IEEE-UCF/boost_converter/lm5032 similar boost conv.asc

C1: cap; 100µ
C2: cap; 5µ
C3: cap; 4.7µ
C4: cap; 500µ
C5: cap; 1µ
C6: cap; 22n
C7: cap; 100p
C8: cap; 100n
D1: diode; VS-E5PH7506
D2: diode; VS-E5PH7506
L1: ind; 470n; Ipk=300 Rser=0.00025
L2: ind; 470n; Ipk=300 Rser=0.00025
M1: nmos; IPP030N10N3
M2: nmos; IPP030N10N3
M3: nmos; IPP030N10N3
M4: nmos; IPP030N10N3
M5: nmos; IPP030N10N3
M6: nmos; IPP030N10N3
M7: nmos; IPP030N10N3
M8: nmos; IPP030N10N3
M9: nmos; IPP030N10N3
M10: nmos; IPP030N10N3
M11: nmos; IPP030N10N3
M12: nmos; IPP030N10N3
M13: nmos; IPP030N10N3
M14: nmos; IPP030N10N3
M15: nmos; IPP030N10N3
M16: nmos; IPP030N10N3
R1: res; 2
R2: res; 2
R3: res; 0.00025
R4: res; 0.00025
R5: res; 25
R6: res; 69k
R7: res; 10k
R8: res; 63.4k
R9: res; 16k
R10: res; 100k
R11: res; 0
R12: res; 10k
U1: LT8277
V1: voltage; 30V
Named nets: 0, Vout, Vin
.tran 0 1s 0
