IEEE-UCF/boost_converter/LM5032 2 Board Design/New folder/LM5032 SB.kicad_pcb

## KiCad design LM5032 2 Board Design/New folder/LM5032 SB.kicad_pcb (2024-06-16)

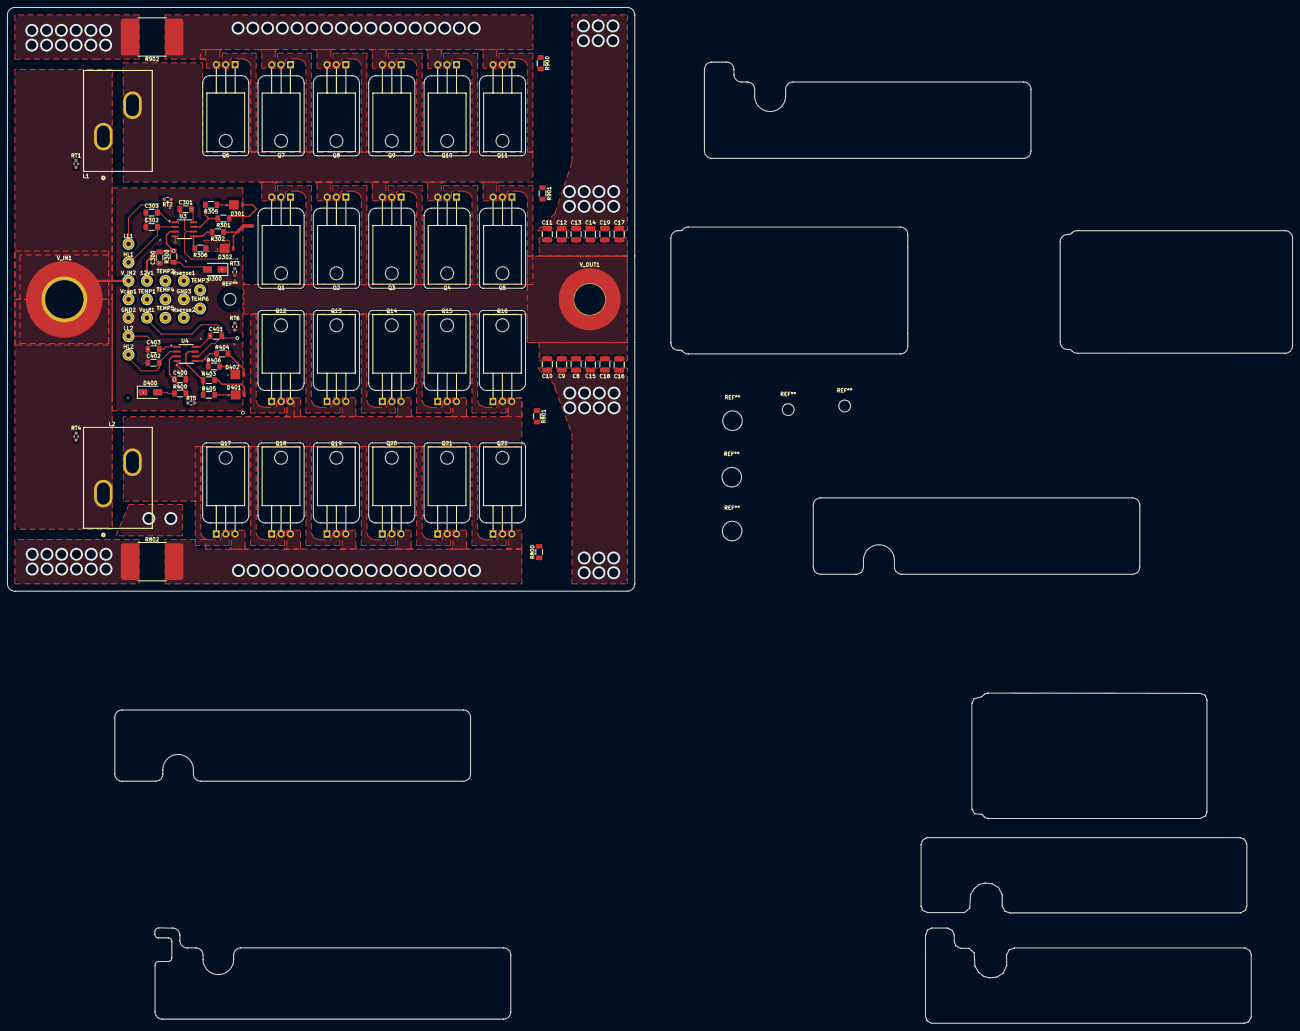
[picture p8: board LM5032 SB.kicad_pcb from above]

Board: 4 copper layers, 170.0 x 158.2 mm, 94 parts (0 on the bottom side), 34 nets.

Parts:
12V1: MountingHole_Pad; TestPoint_THTPad_D2.5mm_Drill1.2mm
C8, C9, C10, C11, C12, C13, C14, C15: 10uF; C_1210_3225Metric_Pad1.33x2.70mm_HandSolder
C16, C17, C18, C19: 0.1uF; C_1210_3225Metric_Pad1.33x2.70mm_HandSolder
C300, C400: 22uF; C_1206_3216Metric_Pad1.33x1.80mm_HandSolder
C301, C401: 2.2uF; C_1206_3216Metric_Pad1.33x1.80mm_HandSolder
C302, C303, C402, C403: 33pF; C_1206_3216Metric_Pad1.33x1.80mm_HandSolder
D300, D400: BYG20J-E3/TR; D_SMA
D301, D302, D401, D402: MBRM130LT1G
GND2, GND3: MountingHole_Pad; TestPoint_THTPad_D2.5mm_Drill1.2mm
HL1, HL2: MountingHole_Pad; TestPoint_THTPad_D2.5mm_Drill1.2mm
L1, L2: 470nH; EDITED-IND_IHDM1107BBEVR47M20_VIS
LL1, LL2: MountingHole_Pad; TestPoint_THTPad_D2.5mm_Drill1.2mm
Q1, Q2, Q3, Q4, Q5, Q6, Q7, Q8, Q9, Q10, Q11, Q12, Q13, Q14, Q15, Q16, Q17, Q18, Q19, Q20, Q21, Q22: NMOS; TO-220-3_Horizontal_TabDown edited pins
R300, R400: 49.9; R_1206_3216Metric_Pad1.30x1.75mm_HandSolder
R301, R302, R403, R404: 3.3; R_1206_3216Metric_Pad1.30x1.75mm_HandSolder
R305, R306, R405, R406: 2.2; R_1206_3216Metric_Pad1.30x1.75mm_HandSolder
R800, R801, R900, R901: 1k; R_1206_3216Metric_Pad1.30x1.75mm_HandSolder
R802, R902: 0.0001; PSR500HTQFB0L10
RT1, RT2, RT3, RT4, RT5, RT6: 36.5k; R_0603_1608Metric_Pad0.98x0.95mm_HandSolder
Rsense1, Rsense2: MountingHole_Pad; TestPoint_THTPad_D2.5mm_Drill1.2mm
TEMP1, TEMP2, TEMP3, TEMP4, TEMP5, TEMP6: MountingHole_Pad; TestPoint_THTPad_D2.5mm_Drill1.2mm
U3, U4: UCC27712DR; SOIC127P599X175-8N
V_IN1: MountingHole_Pad; MountingHole_8.4mm_M8_Pad_TopBottom
V_IN2: MountingHole_Pad; TestPoint_THTPad_D2.5mm_Drill1.2mm
V_OUT1: MountingHole_Pad; MountingHole_8.4mm_M8_Pad_TopBottom
Vcap1: MountingHole_Pad; TestPoint_THTPad_D2.5mm_Drill1.2mm
Vout1: MountingHole_Pad; TestPoint_THTPad_D2.5mm_Drill1.2mm

Connections:
/12V: 12V1.1, C300.2, C400.2, R300.2, R400.2, U3.3 (VDD), U4.3 (VDD)
/HL1: C302.2, HL1.1, U3.2 (HL)
/HL2: C402.2, HL2.1, U4.2 (HL)
/HO1: D301.2 (A), Q1.2 (G), Q2.2 (G), Q3.2 (G), Q4.2 (G), Q5.2 (G), R301.1, R901.2
/HO2: D401.2 (A), Q12.2 (G), Q13.2 (G), Q14.2 (G), Q15.2 (G), Q16.2 (G), R403.1, R801.2
/LL1: C303.2, LL1.1, U3.1 (LL)
/LL2: C403.2, LL2.1, U4.1 (LL)
/LO1: D302.2 (A), Q6.2 (G), Q7.2 (G), Q8.2 (G), Q9.2 (G), Q10.2 (G), Q11.2 (G), R302.1, R900.2
/LO2: D402.2 (A), Q17.2 (G), Q18.2 (G), Q19.2 (G), Q20.2 (G), Q21.2 (G), Q22.2 (G), R404.1, R800.2
/Rsense1: Q6.3 (S), Q7.3 (S), Q8.3 (S), Q9.3 (S), Q10.3 (S), Q11.3 (S), R900.1, R902.1, Rsense1.1
/Rsense2: Q17.3 (S), Q18.3 (S), Q19.3 (S), Q20.3 (S), Q21.3 (S), Q22.3 (S), R800.1, R802.1, Rsense2.1
GND: C8.2, C9.2, C10.2, C11.2, C12.2, C13.2, C14.2, C15.2, C16.2, C17.2, C18.2, C19.2, C300.1, C302.1, C303.1, C400.1, C402.1, C403.1, GND2.1, GND3.1, R802.2, R902.2, RT1.1, RT2.1, RT3.2, RT4.2, RT5.2, RT6.2, U3.4 (COM), U4.4 (COM)
unnamed: D300.2 (A), R300.1
unnamed: C301.1, D300.1 (K), U3.8 (HB)
unnamed: D301.1 (K), R305.1
unnamed: D302.1 (K), R306.1
unnamed: D400.2 (A), R400.1
unnamed: C401.1, D400.1 (K), U4.8 (HB)
unnamed: D401.1 (K), R405.1
unnamed: D402.1 (K), R406.1
unnamed: L1.2, Q1.3 (S), Q2.3 (S), Q3.3 (S), Q4.3 (S), Q5.3 (S), Q6.1 (D), Q7.1 (D), Q8.1 (D), Q9.1 (D), Q10.1 (D), Q11.1 (D), R901.1
unnamed: L2.2, Q12.3 (S), Q13.3 (S), Q14.3 (S), Q15.3 (S), Q16.3 (S), Q17.1 (D), Q18.1 (D), Q19.1 (D), Q20.1 (D), Q21.1 (D), Q22.1 (D), R801.1
unnamed: RT1.2, TEMP1.1
unnamed: RT2.2, TEMP2.1
unnamed: RT3.1, TEMP3.1
unnamed: RT4.1, TEMP4.1
unnamed: RT5.1, TEMP5.1
unnamed: RT6.1, TEMP6.1
unnamed: R301.2, R305.2, U3.7 (HO)
unnamed: R302.2, R306.2, U3.5 (LO)
unnamed: R403.2, R405.2, U4.7 (HO)
unnamed: R404.2, R406.2, U4.5 (LO)
Vin: L1.1, L2.1, V_IN1.1, V_IN2.1, Vcap1.1
Vout: C8.1, C9.1, C10.1, C11.1, C12.1, C13.1, C14.1, C15.1, C16.1, C17.1, C18.1, C19.1, C301.2, C401.2, Q1.1 (D), Q2.1 (D), Q3.1 (D), Q4.1 (D), Q5.1 (D), Q12.1 (D), Q13.1 (D), Q14.1 (D), Q15.1 (D), Q16.1 (D), U3.6 (HS), U4.6 (HS), V_OUT1.1, Vout1.1
