IEEE-UCF/boost_converter/LM5032 2 Board Design/LM5032 Control Board.kicad_pcb

## KiCad design LM5032 2 Board Design/LM5032 Control Board.kicad_pcb (2024-06-16)

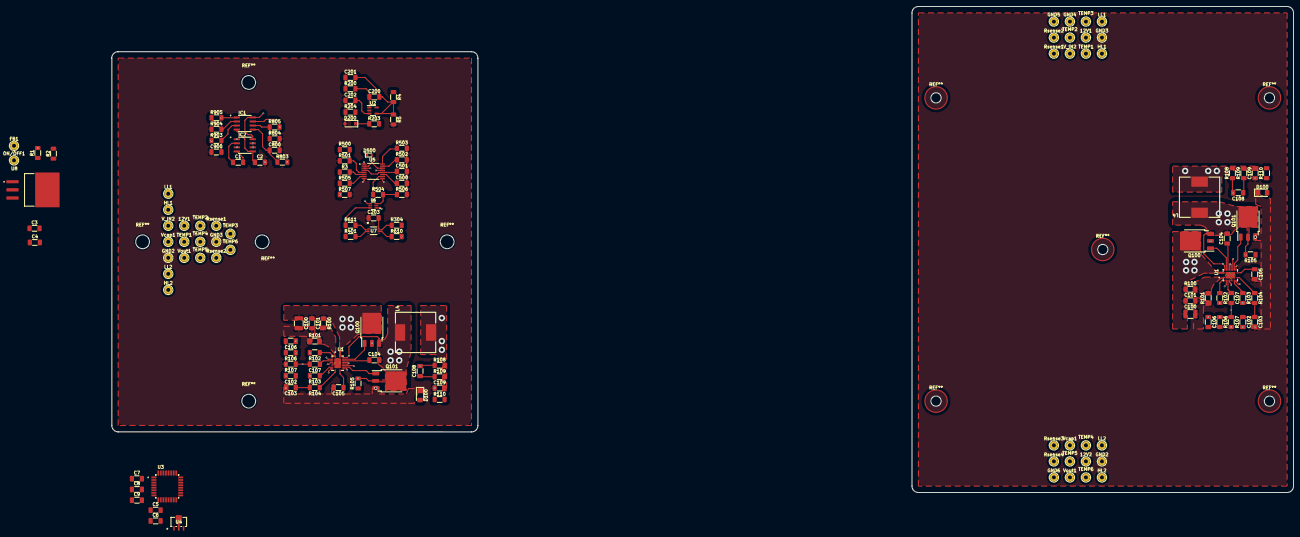
[picture p9: board LM5032 Control Board.kicad_pcb from above]

Board: 4 copper layers, 368.6 x 151.6 mm, 150 parts (0 on the bottom side), 60 nets.

Parts:
12V1, 12V1#2, 12V2: MountingHole_Pad; TestPoint_THTPad_D2.5mm_Drill1.2mm
C1, C2, C4, C5: 1uF; C_1206_3216Metric_Pad1.33x1.80mm_HandSolder
C3: 4.7uF; C_1206_3216Metric_Pad1.33x1.80mm_HandSolder
C6: 10uF; C_1206_3216Metric_Pad1.33x1.80mm_HandSolder
C7, C8, C9, C201, C202, C203, C500, C501: 0.1uF; C_1206_3216Metric_Pad1.33x1.80mm_HandSolder
C100, C100#2: 10uF; C_1210_3225Metric_Pad1.33x2.70mm_HandSolder
C101, C101#2, C104, C104#2, C105, C105#2: 100nF; C_1206_3216Metric_Pad1.33x1.80mm_HandSolder
C102, C102#2: 56nF; C_1206_3216Metric_Pad1.33x1.80mm_HandSolder
C103, C103#2: 2.2uF; C_1206_3216Metric_Pad1.33x1.80mm_HandSolder
C106, C106#2: 8.2nF; C_1206_3216Metric_Pad1.33x1.80mm_HandSolder
C107, C107#2, C200: 470pF; C_1206_3216Metric_Pad1.33x1.80mm_HandSolder
C108, C108#2: 820pF; C_1206_3216Metric_Pad1.33x1.80mm_HandSolder
C109, C109#2: 22uF; C_1206_3216Metric_Pad1.33x1.80mm_HandSolder
C800, C900: 100pF; C_1206_3216Metric_Pad1.33x1.80mm_HandSolder
D100, D100#2: LED; LED_1206_3216Metric_Pad1.42x1.75mm_HandSolder
D200: 2.0V; D_SOD-123
D500: CMOD4448 TR PBFREE; D_SOD-523
FB1: MountingHole_Pad; TestPoint_THTPad_D2.5mm_Drill1.2mm
GND2, GND2#2, GND3, GND3#2, GND4, GND5, GND6: MountingHole_Pad; TestPoint_THTPad_D2.5mm_Drill1.2mm
HL1, HL1#2, HL2, HL2#2: MountingHole_Pad; TestPoint_THTPad_D2.5mm_Drill1.2mm
IC1: AD8092ARZ; SOIC127P600X175-8N
IC2: MAX1681ESA+; SOIC127P600X175-8N
L4, L4#2: 22uH; IND_MSS1210_COC
LL1, LL1#2, LL2, LL2#2: MountingHole_Pad; TestPoint_THTPad_D2.5mm_Drill1.2mm
ON/OFF1: MountingHole_Pad; TestPoint_THTPad_D2.5mm_Drill1.2mm
Q100, Q100#2, Q101, Q101#2: DMT10H009LK3-13; TO-252-3_TabPin2 modded
R1: 5.36k (47k); R_1206_3216Metric_Pad1.30x1.75mm_HandSolder
R2, R3, R110, R110#2, R610, R611: 1k; R_1206_3216Metric_Pad1.30x1.75mm_HandSolder
R4: 36.5k; R_1206_3216Metric_Pad1.30x1.75mm_HandSolder
R5: 1.37k; R_1206_3216Metric_Pad1.30x1.75mm_HandSolder
R100, R100#2: 62.0k; R_1206_3216Metric_Pad1.30x1.75mm_HandSolder
R101, R101#2: 4.99k; R_1206_3216Metric_Pad1.30x1.75mm_HandSolder
R102, R102#2: 39.2k; R_1206_3216Metric_Pad1.30x1.75mm_HandSolder
R103, R103#2, R104, R104#2: 20k; R_1206_3216Metric_Pad1.30x1.75mm_HandSolder
R105, R105#2: 866; R_1206_3216Metric_Pad1.30x1.75mm_HandSolder
R106, R106#2: 2.87k; R_1206_3216Metric_Pad1.30x1.75mm_HandSolder
R107, R107#2: 1.27k; R_1206_3216Metric_Pad1.30x1.75mm_HandSolder
R108, R108#2: 18k; R_1206_3216Metric_Pad1.30x1.75mm_HandSolder
R109, R109#2: 24.9; R_1206_3216Metric_Pad1.30x1.75mm_HandSolder
R200: 30.1k; R_1206_3216Metric_Pad1.30x1.75mm_HandSolder
R203, R204: 2.0k; R_1206_3216Metric_Pad1.30x1.75mm_HandSolder
R304, R401, R504, R505, R506, R507: 150; R_1206_3216Metric_Pad1.30x1.75mm_HandSolder
R500: 36.5k (35.7k); R_1206_3216Metric_Pad1.30x1.75mm_HandSolder
R501: 1.1k; R_1206_3216Metric_Pad1.30x1.75mm_HandSolder
R502, R503: 34.1k; R_1206_3216Metric_Pad1.30x1.75mm_HandSolder
R803, R903: 300; R_1206_3216Metric_Pad1.30x1.75mm_HandSolder
R804, R904: 10k; R_1206_3216Metric_Pad1.30x1.75mm_HandSolder
R805, R905: 148k; R_1206_3216Metric_Pad1.30x1.75mm_HandSolder
Rsense1, Rsense1#2, Rsense2, Rsense2#2, Rsense3, Rsense4: MountingHole_Pad; TestPoint_THTPad_D2.5mm_Drill1.2mm
TEMP1, TEMP1#2, TEMP2, TEMP2#2, TEMP3, TEMP3#2, TEMP4, TEMP4#2, TEMP5, TEMP5#2, TEMP6, TEMP6#2: MountingHole_Pad; TestPoint_THTPad_D2.5mm_Drill1.2mm
U1, U1#2: LM5146QRGYRQ1; QFN50P450X350X100-21N MODDED
U2: LM8261M5; SOT-23-5
U3: STM32F042K6T6TR; QFP80P900X900X160-32N
U4: MCP1700T-3302E_MB; MCP1700T-3302E_MB updated
U5: LM5032MTCX_NOPB; SOP65P640X120-16N
U6: SN74LVC2G14IDCKRQ1; SOT65P210X110-6N
U7: SN74LVC2G08QDCURQ1; U_VSSOP8_DCU_00_TEX
U8: LM2937ES-5.0; TO254P1524X483-4N modded
V_IN2, V_IN2#2: MountingHole_Pad; TestPoint_THTPad_D2.5mm_Drill1.2mm
Vcap1, Vcap1#2: MountingHole_Pad; TestPoint_THTPad_D2.5mm_Drill1.2mm
Vout1, Vout1#2: MountingHole_Pad; TestPoint_THTPad_D2.5mm_Drill1.2mm

Connections:
/3.3V: C6.2, C7.2, C8.2, C9.2, U3.1 (VDD), U3.5 (VDDA), U3.17 (VDDIO2), U4.3 (VOUT)
/5V: C3.1, C5.2, C203.2, IC1.8 (+VS), IC2.8 (IN), U2.5 (V+), U4.2 (VIN), U6.5 (VCC), U7.8 (VCC), U8.3 (VOUT)
/12V: 12V1.1, 12V1#2.1, C4.2, C109.1, C109#2.1, L4.2, L4#2.2, R108.1, R108#2.1, R109.1, R109#2.1, R110.1, R110#2.1, R203.1, U5.1 (VIN), U8.1 (VIN)
/-5V: C2.2, IC1.4 (-VS), IC2.5 (OUT)
/CS1: IC1.1 (OUT1), R905.1, U5.3 (CS1)
/CS2: IC1.7 (OUT), R805.1, U5.13 (CS2)
/HL1: HL1.1, HL1#2.1, R304.2
/HL2: HL2.1, HL2#2.1, R401.2
/LL1: LL1.1, LL1#2.1, R505.2, R507.1, U6.1 (1A)
/LL2: LL2.1, LL2#2.1, R504.2, R506.1, U6.3 (2A)
/Rsense1: R903.2, Rsense1.1, Rsense2#2.1
/Rsense2: R803.2, Rsense2.1, Rsense4.1
/SS: C501.2, U5.4 (SS1), U5.12 (SS2), U7.1 (1A), U7.5 (2A)
/U5-VCC: R3.2, U5.6 (VCC)
/Vref: C200.2, C201.2, R4.2, R5.1, U2.4 (NEG)
GND: C2.1, C3.2, C4.1, C5.1, C6.1, C7.1, C8.1, C9.1, C100.2, C100#2.2, C101.2, C101#2.2, C103.2, C103#2.2, C105.2, C105#2.2, C109.2, C109#2.2, C202.1, C203.1, C500.1, C501.1, C800.1, C900.1, D100.1 (K), D100#2.1 (K), D200.2 (A), GND2.1, GND2#2.1, GND3.1, GND3#2.1, IC2.1 (FSEL), IC2.3 (GND), IC2.6 (LV), IC2.7 (SHDN), Q101.3 (S), Q101#2.3 (S), R5.2, R101.2, R101#2.2, R107.2, R107#2.2, R501.2, R502.2, R503.2, R506.2, R507.2, R804.2, R904.2, U1.6 (AGND), U1.9 (NC), U1.12 (PGND), U1.15 (EP), U1.16 (NC), U1.21 (EP), U1#2.6 (AGND), U1#2.9 (NC), U1#2.12 (PGND), U1#2.15 (EP), U1#2.16 (NC), U1#2.21 (EP), U2.2 (V-), U3.16 (VSS), U3.32 (VSS), U4.1 (GND), U5.8 (GND1), U5.9 (GND2), U6.2 (GND), U7.4 (GND), U8.2 (GND)
unnamed: C106.1, C106#2.1, R106.2, R106#2.2
unnamed: C108.1, C108#2.1, R109.2, R109#2.2
unnamed: C201.1, R200.2
unnamed: D100.2 (A), D100#2.2 (A), R110.2, R110#2.2
unnamed: D200.1 (K), R203.2, R204.2
unnamed: D500.2 (A), U5.2 (COMP1), U5.14 (COMP2)
unnamed: C200.1, D500.1 (K), R200.1, U2.1 (OUT)
unnamed: FB1.1, R3.1
unnamed: C900.2, IC1.3 (+IN1), R903.1
unnamed: C800.2, IC1.5 (+IN2), R803.1
unnamed: IC1.2 (-IN1), R904.1, R905.2
unnamed: IC1.6 (-IN2), R804.1, R805.2
unnamed: C1.2, IC2.2 (CAP+)
unnamed: C1.1, IC2.4 (CAP-)
unnamed: ON/OFF1.1, R1.1
unnamed: Q100.2 (G), Q100#2.2 (G), U1.18 (HO), U1#2.18 (HO)
unnamed: C104.2, C104#2.2, L4.1, L4#2.1, Q100.3 (S), Q100#2.3 (S), Q101.1 (D), Q101#2.1 (D), R105.1, R105#2.1, U1.19 (SW), U1#2.19 (SW)
unnamed: Q101.2 (G), Q101#2.2 (G), U1.13 (LO), U1#2.13 (LO)
unnamed: R2.1, Vcap1.1
unnamed: C104.1, C104#2.1, U1.17 (BST), U1#2.17 (BST)
unnamed: C106.2, C106#2.2, C107.2, C107#2.2, U1.4 (COMP), U1#2.4 (COMP)
unnamed: R100.2, R100#2.2, R101.1, R101#2.1, U1.1 (EN_UVLO), U1#2.1 (EN_UVLO)
unnamed: C107.1, C107#2.1, C108.2, C108#2.2, R106.1, R106#2.1, R107.1, R107#2.1, R108.2, R108#2.2, U1.5 (FB), U1#2.5 (FB)
unnamed: C105.1, C105#2.1, R105.2, R105#2.2, U1.11 (ILIM), U1#2.11 (ILIM)
unnamed: R104.1, R104#2.1, U1.10 (PGOOD), U1#2.10 (PGOOD)
unnamed: R102.1, R102#2.1, U1.2 (RT), U1#2.2 (RT)
unnamed: C102.1, C102#2.1, U1.3 (SS_TRK), U1#2.3 (SS_TRK)
unnamed: R103.1, R103#2.1, U1.8 (SYNCIN), U1#2.8 (SYNCIN)
unnamed: C102.2, C102#2.2, C103.1, C103#2.1, R102.2, R102#2.2, R103.2, R103#2.2, R104.2, R104#2.2, U1.14 (VCC), U1#2.14 (VCC)
unnamed: C202.2, R204.1, U2.3 (POS)
unnamed: R502.1, U5.15 (DCL)
unnamed: R505.1, U5.7 (OUT1)
unnamed: R504.1, U5.10 (OUT2)
unnamed: C500.2, U5.11 (RES)
unnamed: R503.1, U5.16 (RT/SYNC)
unnamed: R1.2, R500.2, R501.1, U5.5 (UVLO)
unnamed: R611.1, U6.6 (1Y)
unnamed: R610.1, U6.4 (2Y)
unnamed: R611.2, U7.2 (1B)
unnamed: R304.1, U7.7 (1Y)
unnamed: R610.2, U7.6 (2B)
unnamed: R401.1, U7.3 (2Y)
Vin: C100.1, C100#2.1, C101.1, C101#2.1, Q100.1 (D), Q100#2.1 (D), R2.2, R100.1, R100#2.1, R500.1, U1.20 (VIN), U1#2.20 (VIN), V_IN2.1, V_IN2#2.1, Vcap1#2.1
Vout: R4.1, Vout1.1, Vout1#2.1
