IEEE-UCF/boost_converter/LM5032 Boost Converter Sch.kicad_pcb

## KiCad design LM5032 Boost Converter Sch.kicad_pcb (2024-05-06)

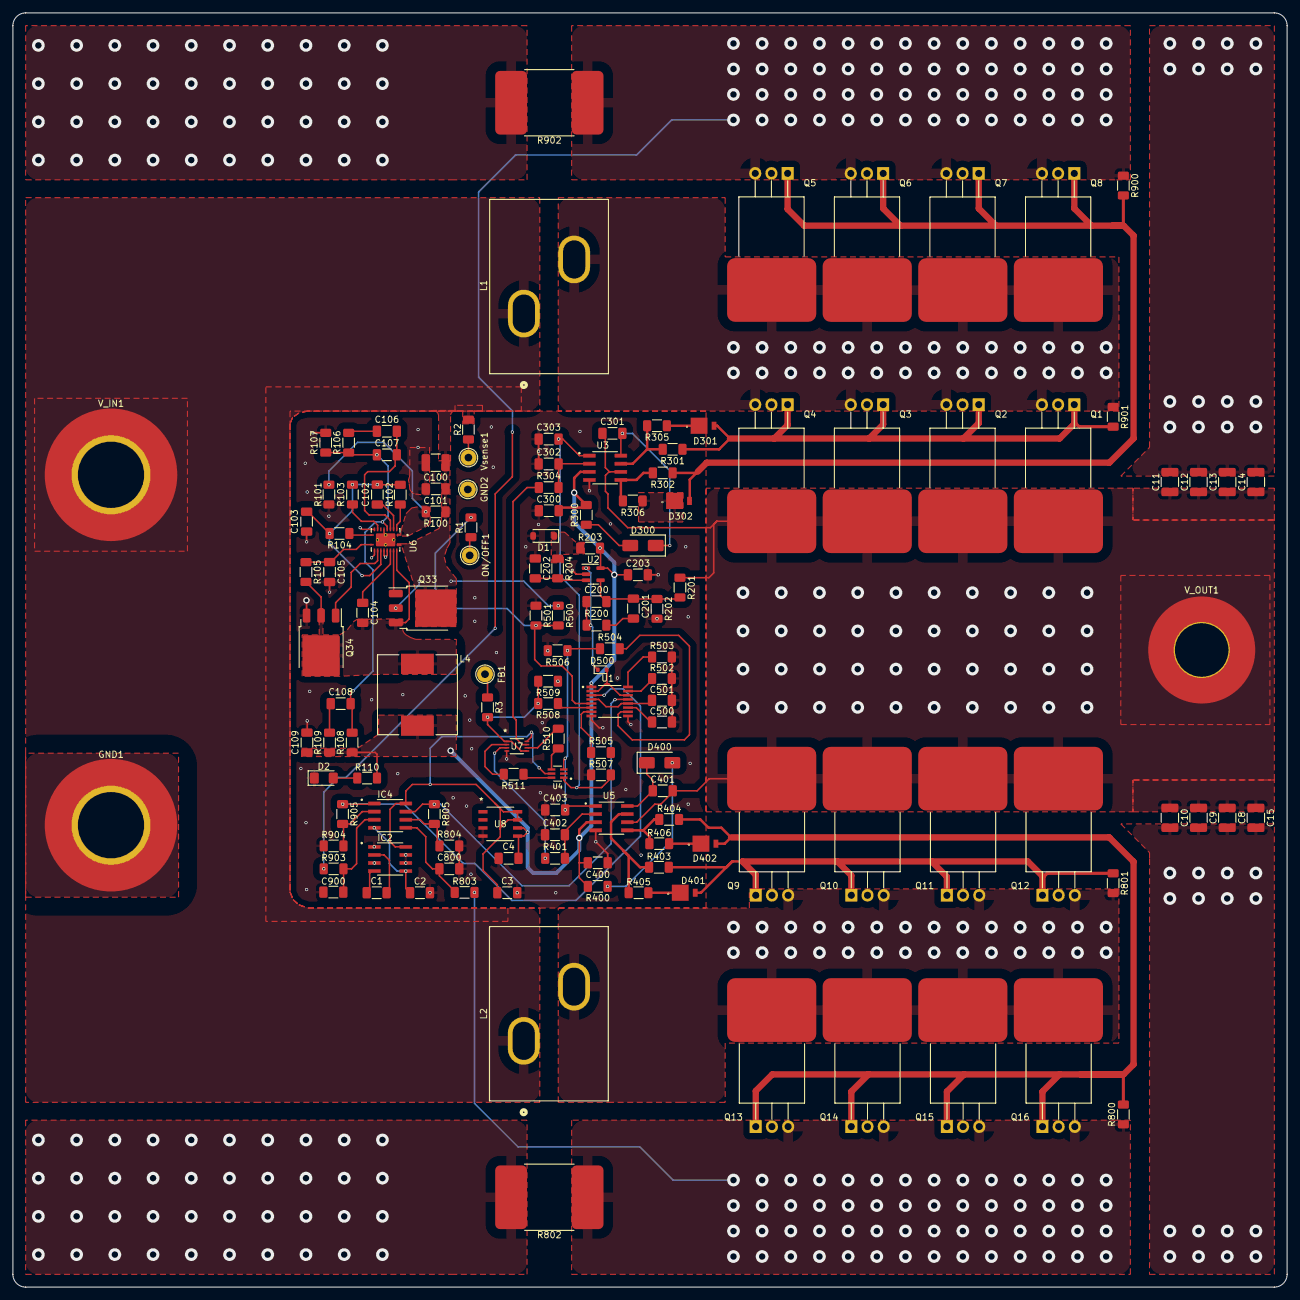
[picture p10: board LM5032 Boost Converter Sch.kicad_pcb from above]

Board: 2 copper layers, 200.0 x 200.0 mm, 140 parts (0 on the bottom side), 78 nets.

Parts:
C1, C2, C4: 1uF; C_1206_3216Metric_Pad1.33x1.80mm_HandSolder
C3: 4.7uF; C_1206_3216Metric_Pad1.33x1.80mm_HandSolder
C8, C9, C10, C11, C12, C13, C14, C15, C100: 10uF; C_1210_3225Metric_Pad1.33x2.70mm_HandSolder
C101, C104, C105: 100nF; C_1206_3216Metric_Pad1.33x1.80mm_HandSolder
C102: 56nF; C_1206_3216Metric_Pad1.33x1.80mm_HandSolder
C103, C301, C401: 2.2uF; C_1206_3216Metric_Pad1.33x1.80mm_HandSolder
C106: 8.2nF; C_1206_3216Metric_Pad1.33x1.80mm_HandSolder
C107, C200: 470pF; C_1206_3216Metric_Pad1.33x1.80mm_HandSolder
C108: 820pF; C_1206_3216Metric_Pad1.33x1.80mm_HandSolder
C109, C300, C400: 22uF; C_1206_3216Metric_Pad1.33x1.80mm_HandSolder
C201, C202, C203, C500, C501: 0.1uF; C_1206_3216Metric_Pad1.33x1.80mm_HandSolder
C302, C303, C402, C403: 33pF; C_1206_3216Metric_Pad1.33x1.80mm_HandSolder
C800, C900: 100pF; C_1206_3216Metric_Pad1.33x1.80mm_HandSolder
D1: 2.0V; D_SOD-123
D2: LED; LED_1206_3216Metric_Pad1.42x1.75mm_HandSolder
D300, D400: BYG20J-E3/TR; D_SMA
D301, D302, D401, D402: MBRM130LT1G
D500: CMOD4448 TR PBFREE; D_SOD-523
FB1: MountingHole_Pad; TestPoint_THTPad_D2.5mm_Drill1.2mm
GND1: MountingHole_Pad; MountingHole_8.4mm_M8_Pad_TopBottom
GND2: MountingHole_Pad; TestPoint_THTPad_D2.5mm_Drill1.2mm
IC2: MAX1681ESA+; SOIC127P600X175-8N
IC4: AD8092ARZ; SOIC127P600X175-8N
L1, L2: 470nH; EDITED-IND_IHDM1107BBEVR47M20_VIS
L4: 22uH; IND_MSS1210_COC
ON/OFF1: MountingHole_Pad; TestPoint_THTPad_D2.5mm_Drill1.2mm
Q1, Q2, Q3, Q4, Q5, Q6, Q7, Q8, Q9, Q10, Q11, Q12, Q13, Q14, Q15, Q16: NMOS; TO-220-3_Horizontal_TabDown no hole
Q33, Q34: DMT10H009LK3-13; TO-252-3_TabPin2 modded
R1: 47k; R_1206_3216Metric_Pad1.30x1.75mm_HandSolder
R2, R110, R510, R511, R800, R801, R900, R901: 1k; R_1206_3216Metric_Pad1.30x1.75mm_HandSolder
R3, R804, R904: 10k; R_1206_3216Metric_Pad1.30x1.75mm_HandSolder
R100: 62.0k; R_1206_3216Metric_Pad1.30x1.75mm_HandSolder
R101: 4.99k; R_1206_3216Metric_Pad1.30x1.75mm_HandSolder
R102: 39.2k; R_1206_3216Metric_Pad1.30x1.75mm_HandSolder
R103, R104: 20k; R_1206_3216Metric_Pad1.30x1.75mm_HandSolder
R105: 866; R_1206_3216Metric_Pad1.30x1.75mm_HandSolder
R106: 2.87k; R_1206_3216Metric_Pad1.30x1.75mm_HandSolder
R107: 1.27k; R_1206_3216Metric_Pad1.30x1.75mm_HandSolder
R108: 18k; R_1206_3216Metric_Pad1.30x1.75mm_HandSolder
R109: 24.9; R_1206_3216Metric_Pad1.30x1.75mm_HandSolder
R200: 30.1k; R_1206_3216Metric_Pad1.30x1.75mm_HandSolder
R201: 36.5k; R_1206_3216Metric_Pad1.30x1.75mm_HandSolder
R202: 1.37k; R_1206_3216Metric_Pad1.30x1.75mm_HandSolder
R203, R204: 2.0k; R_1206_3216Metric_Pad1.30x1.75mm_HandSolder
R300, R400: 49.9; R_1206_3216Metric_Pad1.30x1.75mm_HandSolder
R301, R302, R403, R404: 3.3; R_1206_3216Metric_Pad1.30x1.75mm_HandSolder
R304, R401, R504, R505, R506, R507, R508, R509: 150; R_1206_3216Metric_Pad1.30x1.75mm_HandSolder
R305, R306, R405, R406: 2.2; R_1206_3216Metric_Pad1.30x1.75mm_HandSolder
R500: 35.7k; R_1206_3216Metric_Pad1.30x1.75mm_HandSolder
R501: 1.1k; R_1206_3216Metric_Pad1.30x1.75mm_HandSolder
R502: 28.7k; R_1206_3216Metric_Pad1.30x1.75mm_HandSolder
R503: 34.1k; R_1206_3216Metric_Pad1.30x1.75mm_HandSolder
R802, R902: 0.0001; PSR500HTQFB0L10
R803, R903: 300; R_1206_3216Metric_Pad1.30x1.75mm_HandSolder
R805, R905: 148k; R_1206_3216Metric_Pad1.30x1.75mm_HandSolder
U1: LM5032MTCX_NOPB; SOP65P640X120-16N
U2: LM8261M5; SOT-23-5
U3, U5: UCC27712DR; SOIC127P599X175-8N
U4: SN74LVC2G14IDCKRQ1; SOT65P210X110-6N
U6: LM5146QRGYRQ1; QFN50P450X350X100-21N MODDED
U7: SN74LVC2G08QDCURQ1; U_VSSOP8_DCU_00_TEX
U8: TPS76650DRM3; D8
V_IN1: MountingHole_Pad; MountingHole_8.4mm_M8_Pad_TopBottom
V_OUT1: MountingHole_Pad; MountingHole_8.4mm_M8_Pad_TopBottom
Vsense1: MountingHole_Pad; TestPoint_THTPad_D2.5mm_Drill1.2mm

Connections:
/5V: C3.1, IC2.8 (IN), IC4.8 (+VS), U4.5 (VCC), U7.8 (VCC), U8.7 (OUT), U8.8 (OUT)
/12V: C4.2, C109.1, C203.2, C300.2, C400.2, L4.2, R108.1, R109.1, R110.1, R203.1, R300.2, R400.2, U1.1 (VIN), U2.5 (V+), U3.3 (VDD), U5.3 (VDD), U8.5 (IN), U8.6 (IN)
/-5V: C2.2, IC2.5 (OUT), IC4.4 (-VS)
/CS1: IC4.1 (OUT1), R905.1, U1.3 (CS1)
/CS2: IC4.7 (OUT), R805.1, U1.13 (CS2)
/HO1: D301.2 (A), Q1.2 (G), Q2.2 (G), Q3.2 (G), Q4.2 (G), R301.1, R901.2
/HO2: D401.2 (A), Q9.2 (G), Q10.2 (G), Q11.2 (G), Q12.2 (G), R403.1, R801.2
/LO1: D302.2 (A), Q5.2 (G), Q6.2 (G), Q7.2 (G), Q8.2 (G), R302.1, R900.2
/LO2: D402.2 (A), Q13.2 (G), Q14.2 (G), Q15.2 (G), Q16.2 (G), R404.1, R800.2
/U1-VCC: R3.2, R508.1, R509.2, U7.1 (1A), U7.5 (2A)
GND: C2.1, C3.2, C4.1, C8.2, C9.2, C10.2, C11.2, C12.2, C13.2, C14.2, C15.2, C100.2, C101.2, C103.2, C105.2, C109.2, C202.1, C203.1, C300.1, C302.1, C303.1, C400.1, C402.1, C403.1, C500.1, C501.1, C800.1, C900.1, D1.2 (A), D2.1 (K), GND1.1, GND2.1, IC2.1 (FSEL), IC2.3 (GND), IC2.6 (LV), IC2.7 (SHDN), Q34.3 (S), R101.2, R107.2, R202.2, R501.2, R502.2, R503.2, R506.2, R507.2, R509.1, R802.2, R804.2, R902.2, R904.2, U1.8 (GND1), U1.9 (GND2), U2.2 (V-), U3.4 (COM), U4.2 (GND), U5.4 (COM), U6.6 (AGND), U6.9 (NC), U6.12 (PGND), U6.15 (EP), U6.16 (NC), U6.21 (EP), U7.4 (GND), U8.3 (GND), U8.4 (*EN)
unnamed: C106.1, R106.2
unnamed: C108.1, R109.2
unnamed: C201.1, R200.2
unnamed: D1.1 (K), R203.2, R204.2
unnamed: D2.2 (A), R110.2
unnamed: D300.2 (A), R300.1
unnamed: C301.1, D300.1 (K), U3.8 (HB)
unnamed: D301.1 (K), R305.1
unnamed: D302.1 (K), R306.1
unnamed: D400.2 (A), R400.1
unnamed: C401.1, D400.1 (K), U5.8 (HB)
unnamed: D401.1 (K), R405.1
unnamed: D402.1 (K), R406.1
unnamed: D500.2 (A), U1.2 (COMP1), U1.14 (COMP2)
unnamed: C200.1, D500.1 (K), R200.1, U2.1 (OUT)
unnamed: FB1.1, R3.1
unnamed: C1.2, IC2.2 (CAP+)
unnamed: C1.1, IC2.4 (CAP-)
unnamed: C900.2, IC4.3 (+IN1), R903.1
unnamed: C800.2, IC4.5 (+IN2), R803.1
unnamed: IC4.2 (-IN1), R904.1, R905.2
unnamed: IC4.6 (-IN2), R804.1, R805.2
unnamed: ON/OFF1.1, R1.1
unnamed: L1.2, Q1.3 (S), Q2.3 (S), Q3.3 (S), Q4.3 (S), Q5.1 (D), Q6.1 (D), Q7.1 (D), Q8.1 (D), R901.1
unnamed: Q5.3 (S), Q6.3 (S), Q7.3 (S), Q8.3 (S), R900.1, R902.1, R903.2
unnamed: L2.2, Q9.3 (S), Q10.3 (S), Q11.3 (S), Q12.3 (S), Q13.1 (D), Q14.1 (D), Q15.1 (D), Q16.1 (D), R801.1
unnamed: Q13.3 (S), Q14.3 (S), Q15.3 (S), Q16.3 (S), R800.1, R802.1, R803.2
unnamed: Q33.2 (G), U6.18 (HO)
unnamed: C104.2, L4.1, Q33.3 (S), Q34.1 (D), R105.1, U6.19 (SW)
unnamed: Q34.2 (G), U6.13 (LO)
unnamed: R2.1, Vsense1.1
unnamed: R502.1, U1.15 (DCL)
unnamed: R505.1, U1.7 (OUT1)
unnamed: R504.1, U1.10 (OUT2)
unnamed: C500.2, U1.11 (RES)
unnamed: R503.1, U1.16 (RT/SYNC)
unnamed: C501.2, U1.4 (SS1), U1.12 (SS2)
unnamed: R1.2, R500.2, R501.1, U1.5 (UVLO)
unnamed: R508.2, U1.6 (VCC)
unnamed: C200.2, C201.2, R201.2, R202.1, U2.4 (NEG)
unnamed: C202.2, R204.1, U2.3 (POS)
unnamed: C302.2, R304.2, U3.2 (HL)
unnamed: R301.2, R305.2, U3.7 (HO)
unnamed: C303.2, R505.2, R507.1, U3.1 (LL), U4.1 (1A)
unnamed: R302.2, R306.2, U3.5 (LO)
unnamed: R511.1, U4.6 (1Y)
unnamed: C403.2, R504.2, R506.1, U4.3 (2A), U5.1 (LL)
unnamed: R510.1, U4.4 (2Y)
unnamed: C402.2, R401.2, U5.2 (HL)
unnamed: R403.2, R405.2, U5.7 (HO)
unnamed: R404.2, R406.2, U5.5 (LO)
unnamed: C104.1, U6.17 (BST)
unnamed: C106.2, C107.2, U6.4 (COMP)
unnamed: R100.2, R101.1, U6.1 (EN_UVLO)
unnamed: C107.1, C108.2, R106.1, R107.1, R108.2, U6.5 (FB)
unnamed: C105.1, R105.2, U6.11 (ILIM)
unnamed: R104.1, U6.10 (PGOOD)
unnamed: R102.1, U6.2 (RT)
unnamed: C102.1, U6.3 (SS_TRK)
unnamed: R103.1, U6.8 (SYNCIN)
unnamed: C102.2, C103.1, R102.2, R103.2, R104.2, U6.14 (VCC)
unnamed: R511.2, U7.2 (1B)
unnamed: R304.1, U7.7 (1Y)
unnamed: R510.2, U7.6 (2B)
unnamed: R401.1, U7.3 (2Y)
Vin: C100.1, C101.1, L1.1, L2.1, Q33.1 (D), R2.2, R100.1, R500.1, U6.20 (VIN), V_IN1.1
Vout: C8.1, C9.1, C10.1, C11.1, C12.1, C13.1, C14.1, C15.1, C301.2, C401.2, Q1.1 (D), Q2.1 (D), Q3.1 (D), Q4.1 (D), Q9.1 (D), Q10.1 (D), Q11.1 (D), Q12.1 (D), R201.1, U3.6 (HS), U5.6 (HS), V_OUT1.1
